ChronovaEngineering/Sustrans-air-pollution-monitors/Documentation/Photos/Sustrans node on lamppost.jpg

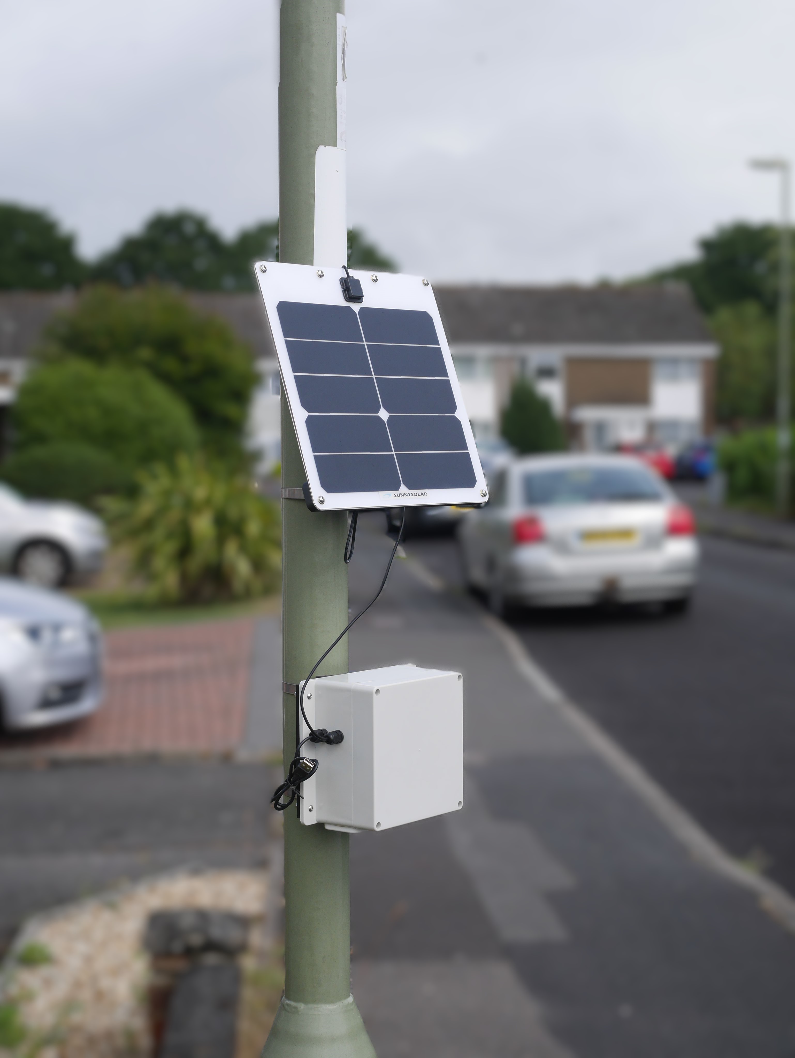
Documentation/Photos/Sustrans node on lamppost.jpg
