ChronovaEngineering/Sustrans-air-pollution-monitors/Documentation/Photos/Sustrans monitors WIP.jpg

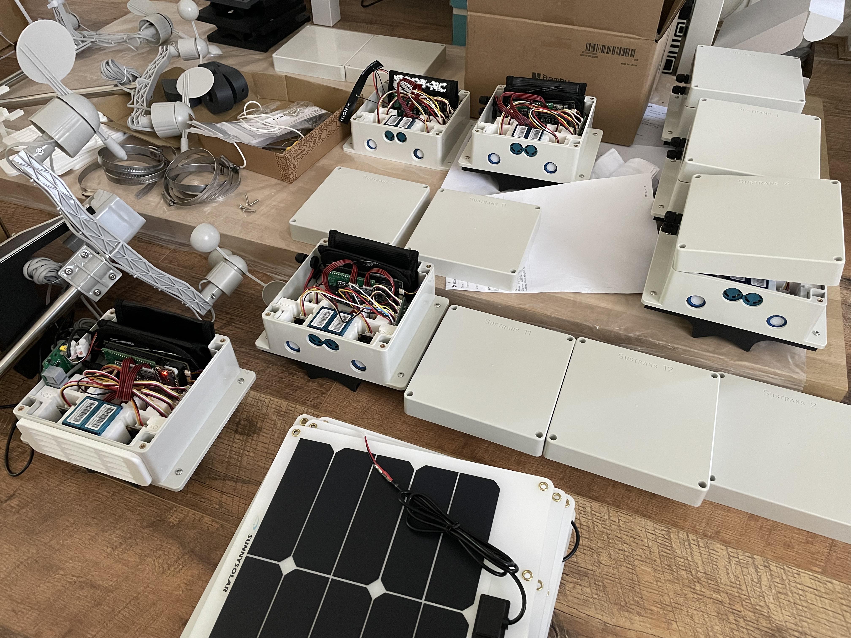
Documentation/Photos/Sustrans monitors WIP.jpg
