ChronovaEngineering/Sustrans-air-pollution-monitors/README.md

**Useful links:**

Demo ThingSpeak Data dashboard: https://thingspeak.com/channels/2498504

Demo Device Health dashboard: https://notehub.io/project/app:8b7caa3c-53ab-4f4c-9cfd-8e915a8eb6c7/devices/dev:867730051250094

Project GitHub: https://github.com/ChronovaEngineering/Sustrans-air-pollution-monitors/tree/main

**ThingSpeak Data dashboards:**

Sustrans 1: https://thingspeak.mathworks.com/channels/2606022

Sustrans 2: https://thingspeak.mathworks.com/channels/2606024

Sustrans 3: https://thingspeak.mathworks.com/channels/2606025

Sustrans 4: https://thingspeak.mathworks.com/channels/2606027

Sustrans 5: https://thingspeak.mathworks.com/channels/2606029

Sustrans 6: https://thingspeak.mathworks.com/channels/2606030

Sustrans 7: https://thingspeak.mathworks.com/channels/2606031

Sustrans 8: https://thingspeak.mathworks.com/channels/2606033

Sustrans 9: https://thingspeak.mathworks.com/channels/2606037

Sustrans 10: https://thingspeak.mathworks.com/channels/2606042

Sustrans 11: https://thingspeak.mathworks.com/channels/2606043

Sustrans 12: https://thingspeak.mathworks.com/channels/2606044

Sustrans 10 - Weather Station: https://thingspeak.mathworks.com/channels/2945913

Sustrans 11 - Weather Station: https://thingspeak.mathworks.com/channels/2945914

Sustrans 12 - Weather Station: https://thingspeak.mathworks.com/channels/2945915

**Device Health Dashboards:**

Sustrans 1: https://notehub.io/project/app:7ee79fa2-71c1-4c6d-bb7c-f2ecd99a6376/devices

Sustrans 2: https://notehub.io/project/app:8b7caa3c-53ab-4f4c-9cfd-8e915a8eb6c7/devices

Sustrans 3: https://notehub.io/project/app:3aaf790e-56ec-4285-ab7f-f440c1299de1/devices

Sustrans 4: https://notehub.io/project/app:555aa929-c07e-4b66-bd92-bda17ffc4d0d/devices

Sustrans 5: https://notehub.io/project/app:b35edc04-2ff1-41e4-8eb8-796e42e225b9/devices

Sustrans 6: https://notehub.io/project/app:ecccdbf8-8041-4e43-95b6-ee5a5410fbdb/devices

Sustrans 7: https://notehub.io/project/app:6d0fe3c4-5146-4f41-a492-03eabeba047e/devices

Sustrans 8: https://notehub.io/project/app:b67d4e1c-5a5e-4a96-9587-f185a83985b8/devices

Sustrans 9: https://notehub.io/project/app:9f5b04f8-4e8d-4287-ba43-f41a4eb7b308/devices

Sustrans 10: https://notehub.io/project/app:3dbe201e-8cf3-4b31-b31c-9043bad0a52a/devices

Sustrans 11: https://notehub.io/project/app:4bf5729a-47a8-489c-b943-e533a00e1db6/devices

Sustrans 12: https://notehub.io/project/app:c8195b89-7f49-4d28-b65b-5e8a307dd357/devices
