ChronovaEngineering/Sustrans-air-pollution-monitors/Documentation/Data flow map.png

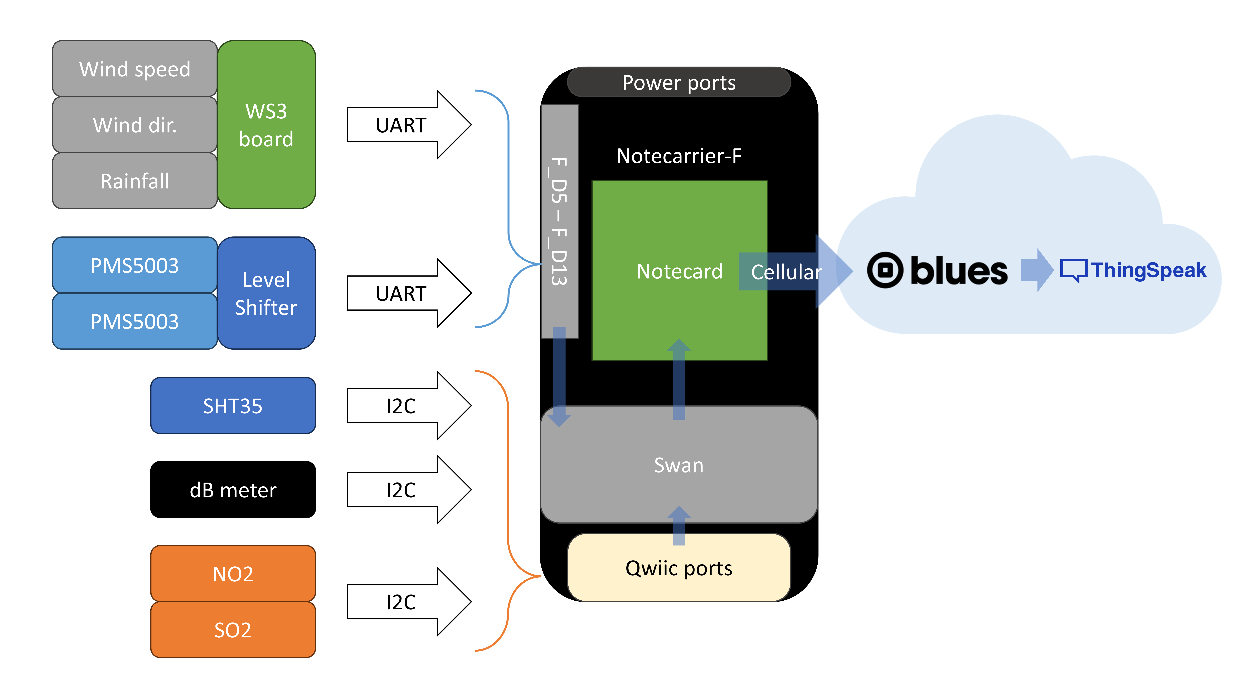
Documentation/Data flow map.png
