ChronovaEngineering/Sustrans-air-pollution-monitors/Documentation/Photos/Internals (prototype).jpg

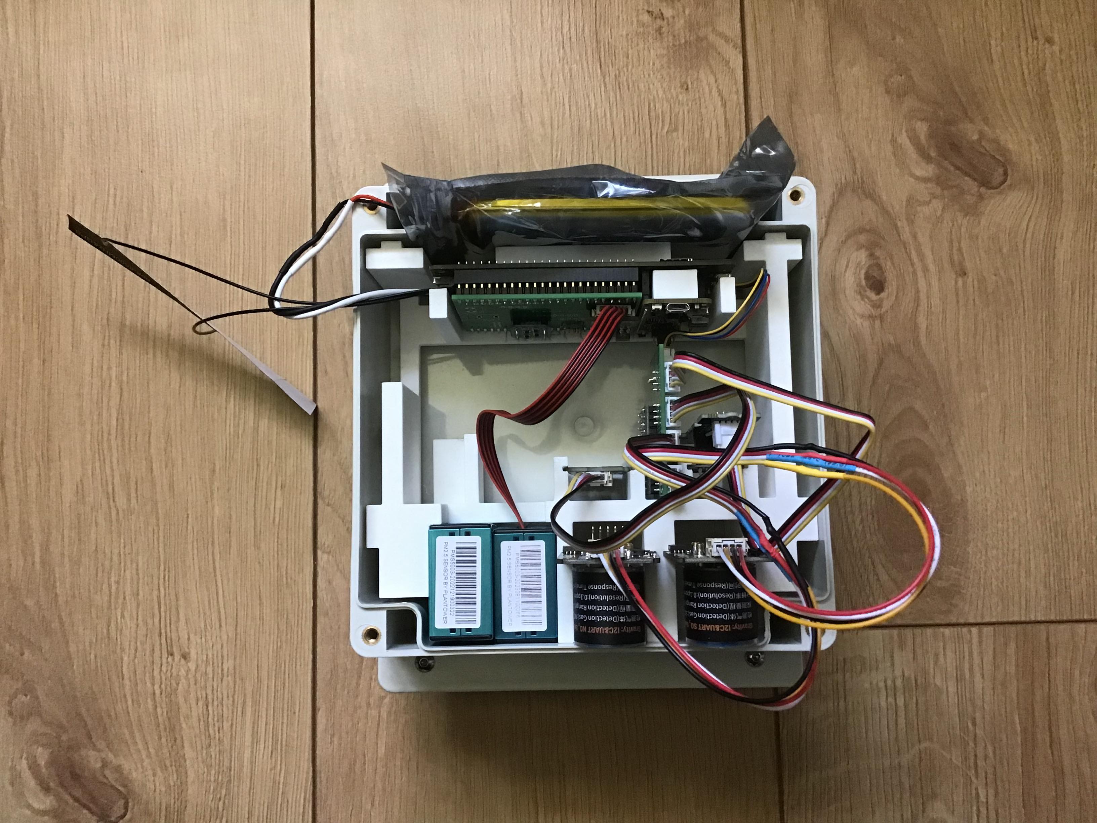
Documentation/Photos/Internals (prototype).jpg
