ChronovaEngineering/Sustrans-air-pollution-monitors/Documentation/Photos/Solar panel bracket.JPG

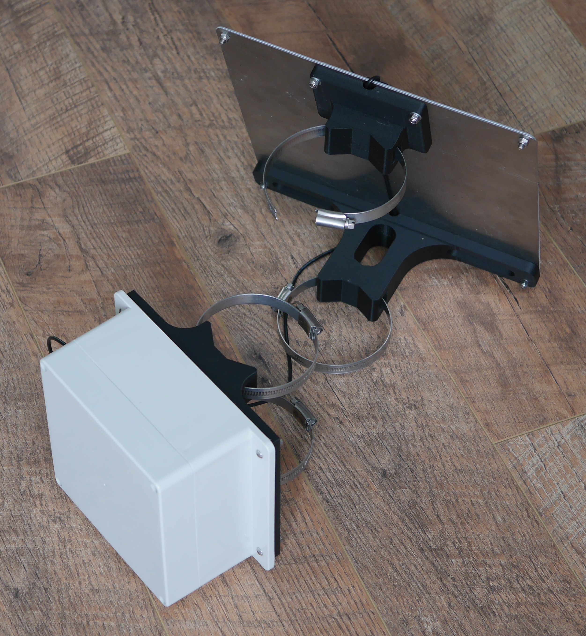
Documentation/Photos/Solar panel bracket.JPG
