ChronovaEngineering/Sustrans-air-pollution-monitors/Documentation/Power map.png

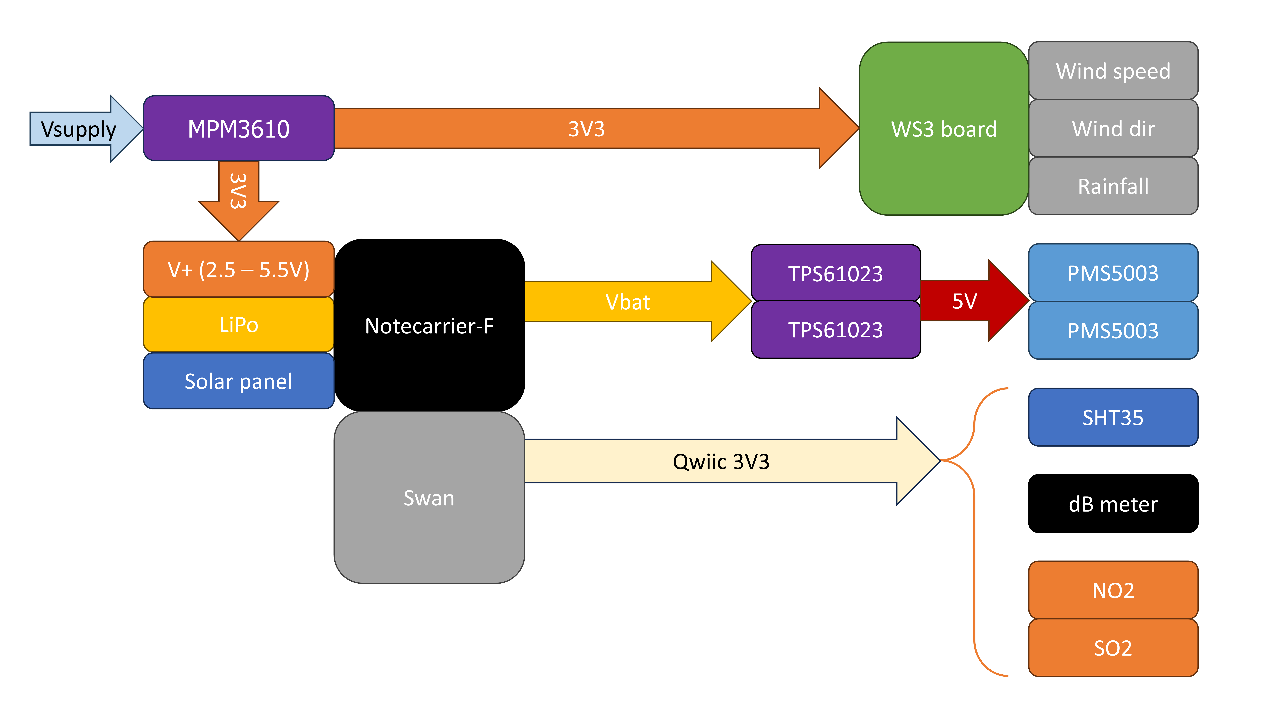
Documentation/Power map.png
