ChronovaEngineering/Sustrans-air-pollution-monitors/Instructions/Blues Device Status.pdf

# Device Status

Blues Notehub Guide

## Step 1: Projects Page

- Sign into the Blues Notehub and go to
https://notehub.io/projects

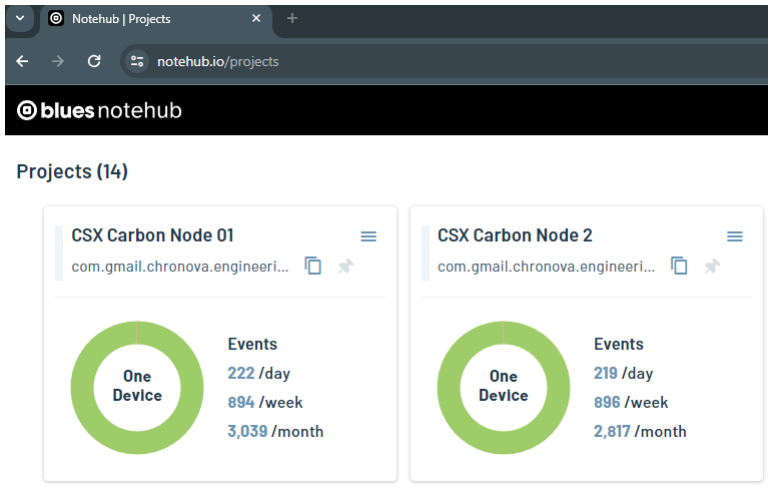
[picture p29: figure]

- Double click on one of the projects to open it

## Step 2: Devices Menu

- In the “Devices”
menu, tick the
checkbox for the
device, then click the
“View” button near
the top right of the
page.
- (Alternatively, doubleclick the device row)

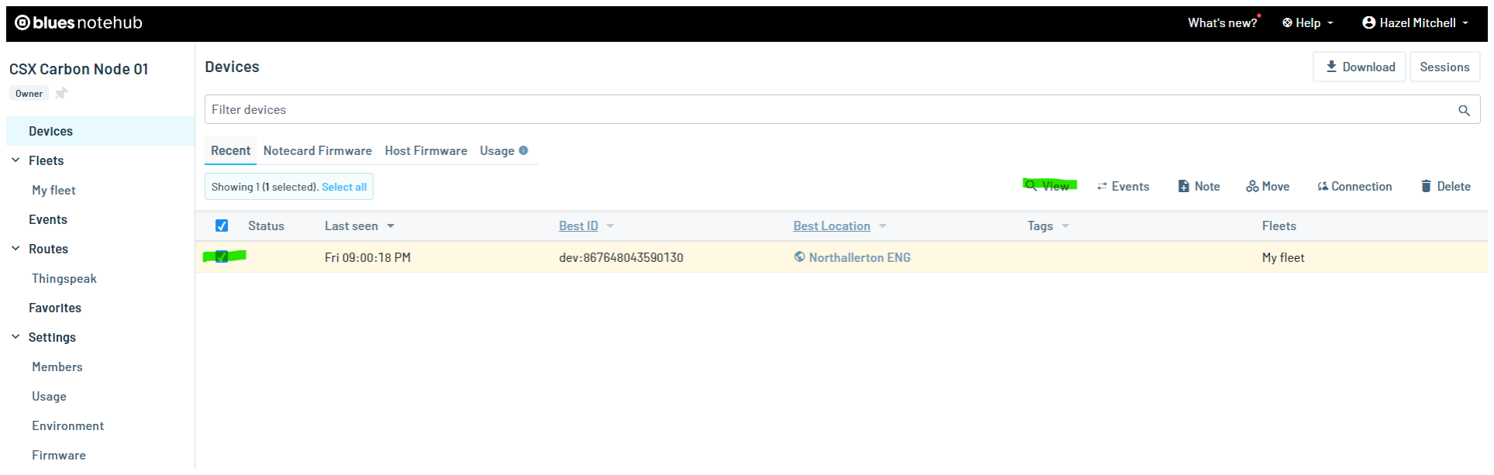
[picture p30: figure]

## Step 3: Device Status

- The device status should now be visible. Scroll down to see graphs of temperature, voltage, signal strength and message counts.

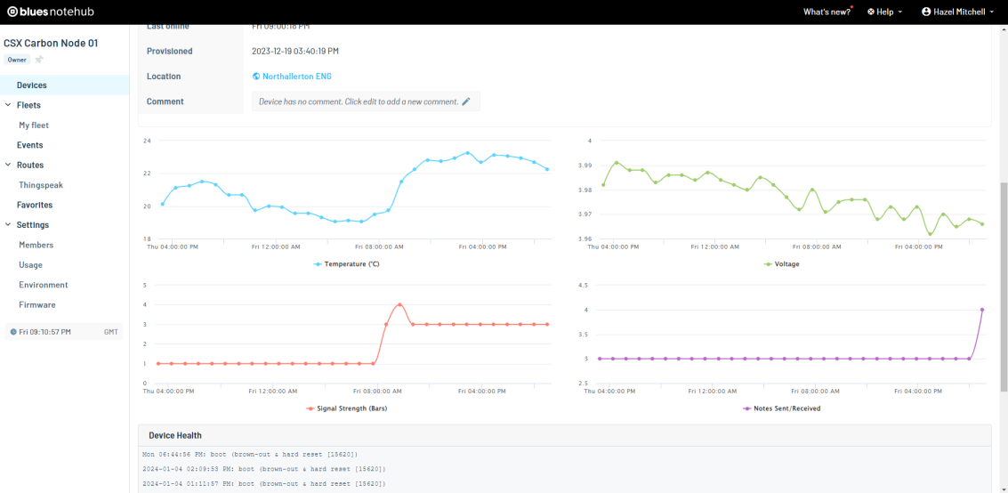
[picture p31: figure]

- Signal strength ranges from 0 to 4 bars, with 4 being the highest signal strength
