ChronovaEngineering/Sustrans-air-pollution-monitors/(commit log)

2024-04-05 Add files via upload
    Basic live demo with local sensor readings
2024-07-07 Rename Enclosure bracket.JPG to Horizontal enclosure bracket.JPG
